MOSH-Insa-Toulouse/SANCHEZ_VIDAL_Projet_Capteur/Conception PCB/CapteurGraphene.asc

B1: bi; I=V(cp,cn)*(10n+(v(gc,gn)*10n))
C0: cap; 200µ
R0: res; 1k
Named nets: gp, gn, cp, cn, gc
