MOSH-Insa-Toulouse/SANCHEZ_VIDAL_Projet_Capteur/Conception PCB/Draft1.asc

C1: cap; 100n
C2: cap; 100n
C4: cap; 1µ
C5: cap; 1p
R1: res; 100k
R2: res; 1k
R3: res; 100k
R4: res; 10k
R5: res; 1k
U1: LTC1050
V1: voltage; 5
V2: voltage; SINE(0 325 50)
V3: voltage; PULSE(0 1 0.2 0.1 0.1 20)
X1: CapteurGraphene
Named nets: 0, ADC, Isens, +5V
.tran 2
